koelschlaeger/T-TWR_Keypad/symbols/PTS526_SK15_SMTR2_LFS.stp

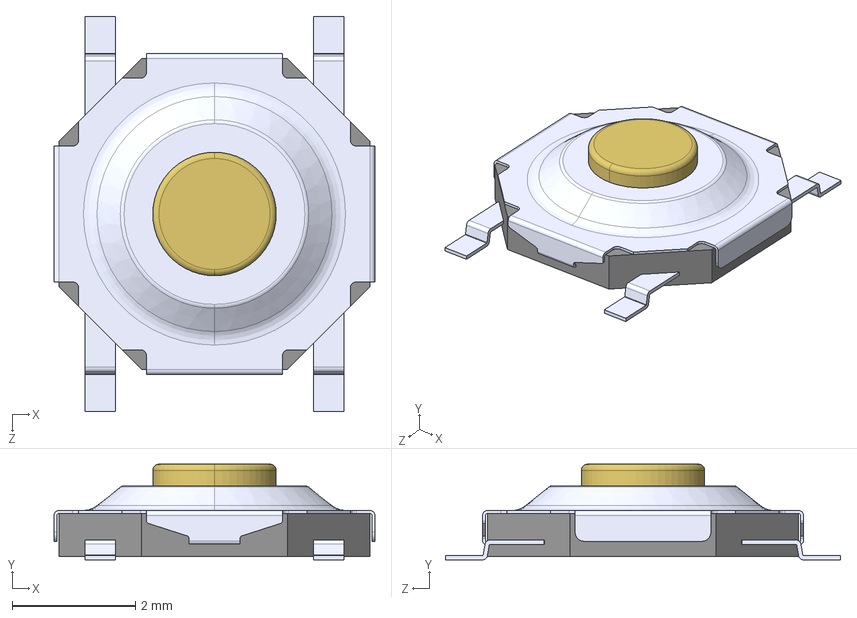
[picture p1: CAD file, 2024-03-25]
symbols/PTS526_SK15_SMTR2_LFS.stp
5.20 x 1.55 x 6.40 mm
