koelschlaeger/T-TWR_Keypad/symbols/RGT0016B.stp

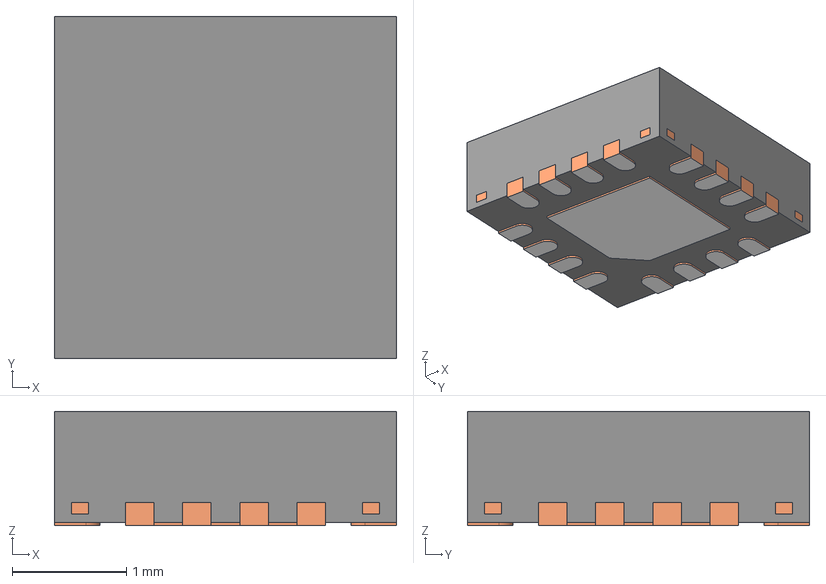
[picture p2: CAD file, 2024-03-25]
symbols/RGT0016B.stp
3.00 x 3.00 x 1.00 mm
BODY-QFN
FRAME-RGT0016B
PIN1-ID
