koelschlaeger/T-TWR_Keypad/symbols/SOT162-1_NXP.step

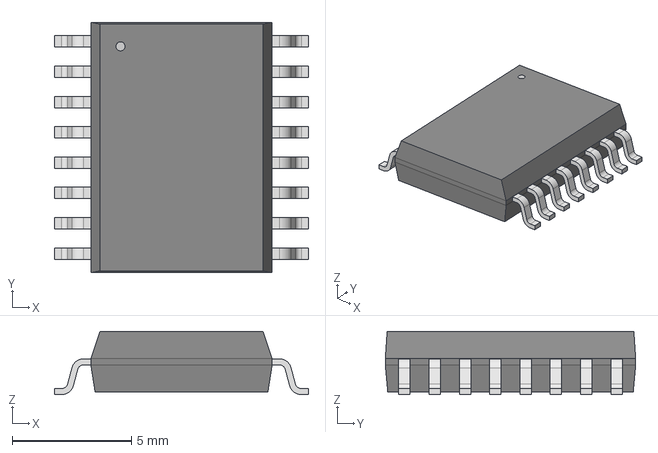
[picture p3: CAD file, 2024-03-25]
symbols/SOT162-1_NXP.step
10.6 x 10.5 x 2.64 mm
