koelschlaeger/T-TWR_Keypad/TTWR Keypad.kicad_pcb

## KiCad design TTWR Keypad.kicad_pcb (2024-04-13)

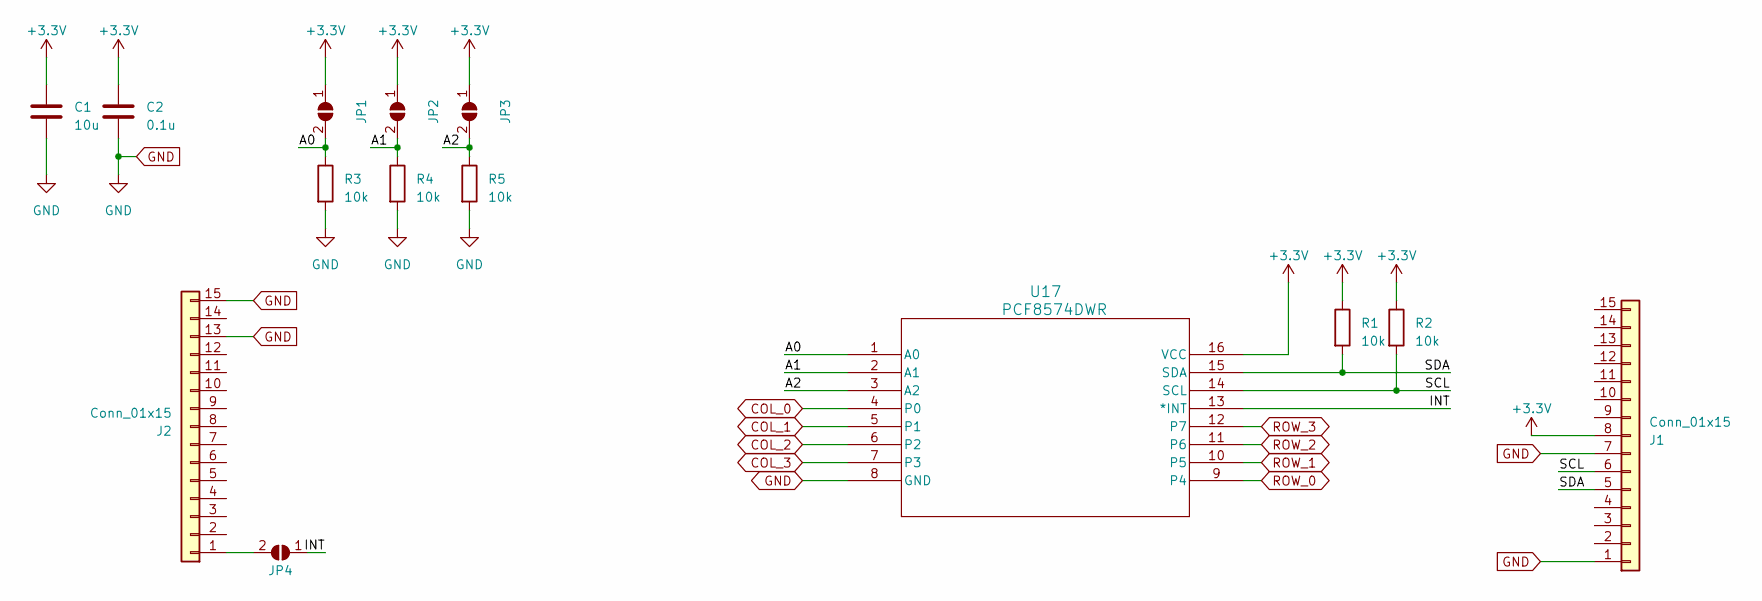
[picture p4: schematic IO Expander.kicad_sch]

Parts:
C1: 10u; C_0603_1608Metric_Pad1.08x0.95mm_HandSolder
C2: 0.1u; C_0603_1608Metric_Pad1.08x0.95mm_HandSolder
J1, J2: Conn_01x15; PinHeader_1x15_P1.00mm_Vertical
JP1, JP2, JP3, JP4: SolderJumper_2_Open; SolderJumper-2_P1.3mm_Open_RoundedPad1.0x1.5mm
R1, R2, R3, R4, R5: 10k; R_0603_1608Metric_Pad0.98x0.95mm_HandSolder
U17: PCF8574DWR; SOT162-1_NXP-M

Connections:
+3.3V: C1.1, C2.1, J1.8, JP1.1 (A), JP2.1 (A), JP3.1 (A), R1.1, R2.1, U17.16 (VCC)
/IO Expander/A0: JP1.2 (B), R3.1, U17.1 (A0)
/IO Expander/A1: JP2.2 (B), R4.1, U17.2 (A1)
/IO Expander/A2: JP3.2 (B), R5.1, U17.3 (A2)
/IO Expander/INT: JP4.1 (A), U17.13 (*INT)
/IO Expander/SCL: J1.6, R2.2, U17.14 (SCL)
/IO Expander/SDA: J1.5, R1.2, U17.15 (SDA)
COL_0: U17.4 (P0); also elsewhere on the board
COL_1: U17.5 (P1); also elsewhere on the board
COL_2: U17.6 (P2); also elsewhere on the board
COL_3: U17.7 (P3); also elsewhere on the board
GND: C1.2, C2.2, J1.1, J1.7, J2.13, J2.15, R3.2, R4.2, R5.2, U17.8 (GND)
unnamed: J2.1, JP4.2 (B)
ROW_0: U17.9 (P4); also elsewhere on the board
ROW_1: U17.10 (P5); also elsewhere on the board
ROW_2: U17.11 (P6); also elsewhere on the board
ROW_3: U17.12 (P7); also elsewhere on the board

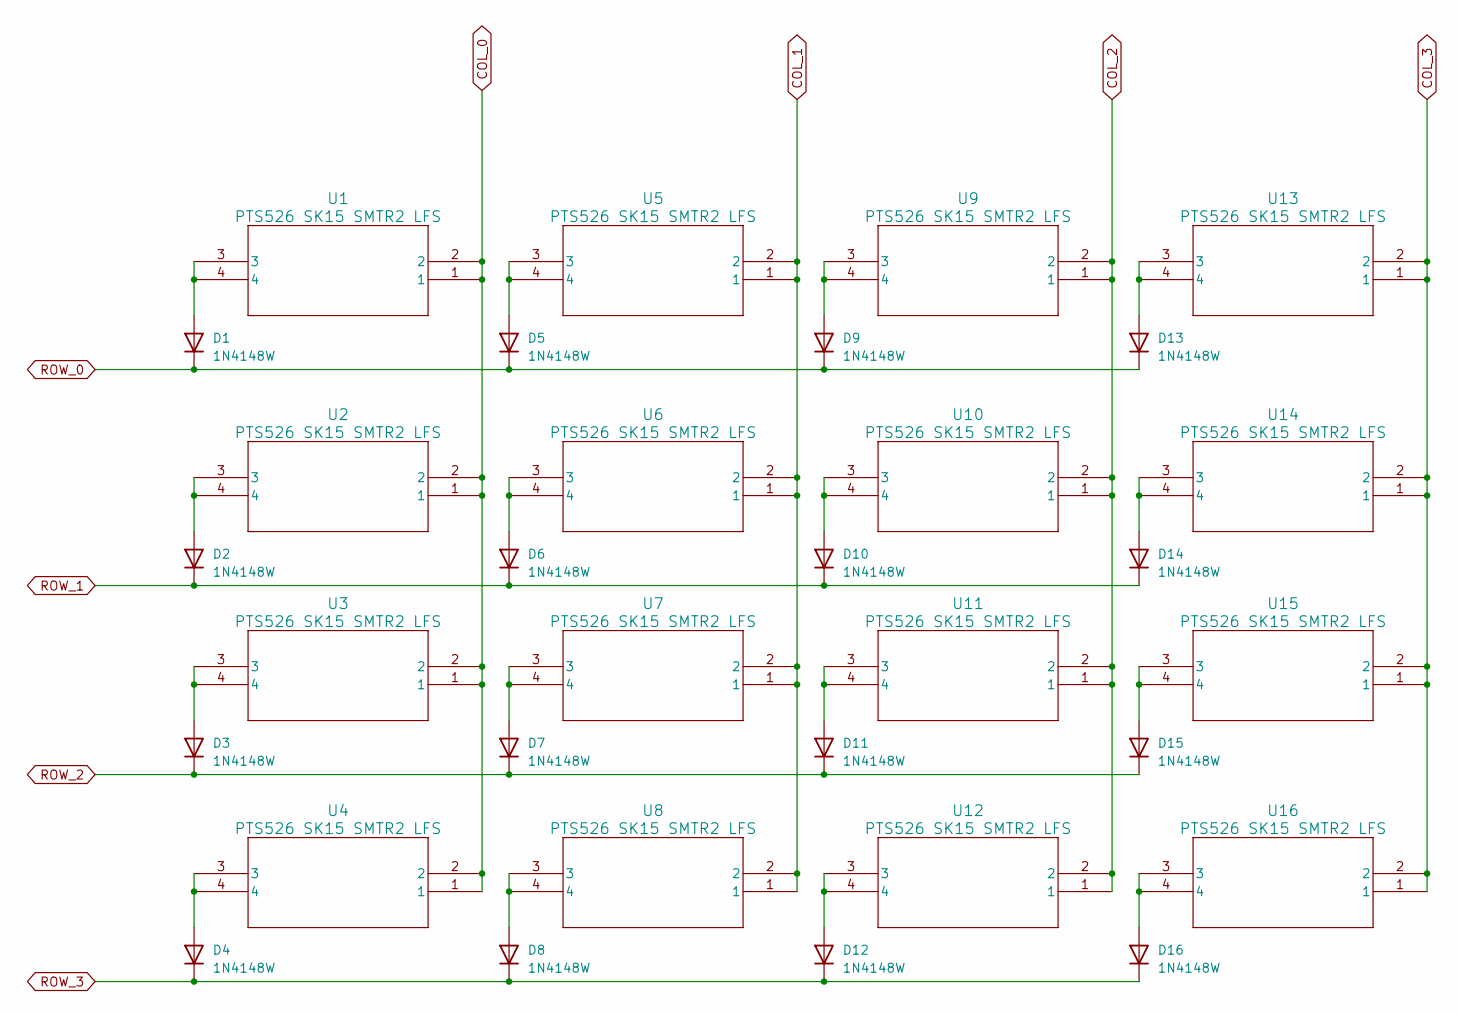
[picture p5: schematic keypad.kicad_sch]

Parts:
D1, D2, D3, D4, D5, D6, D7, D8, D9, D10, D11, D12, D13, D14, D15, D16: 1N4148W; D_SOD-123
U1, U2, U3, U4, U5, U6, U7, U8, U9, U10, U11, U12, U13, U14, U15, U16: PTS526 SK15 SMTR2 LFS; PTS526_SK15_SMTR2_LFS

Connections:
COL_0: U1.1, U1.2, U2.1, U2.2, U3.1, U3.2, U4.1, U4.2; also elsewhere on the board
COL_1: U5.1, U5.2, U6.1, U6.2, U7.1, U7.2, U8.1, U8.2; also elsewhere on the board
COL_2: U9.1, U9.2, U10.1, U10.2, U11.1, U11.2, U12.1, U12.2; also elsewhere on the board
COL_3: U13.1, U13.2, U14.1, U14.2, U15.1, U15.2, U16.1, U16.2; also elsewhere on the board
unnamed: D1.2 (A), U1.3, U1.4
unnamed: D2.2 (A), U2.3, U2.4
unnamed: D3.2 (A), U3.3, U3.4
unnamed: D4.2 (A), U4.3, U4.4
unnamed: D5.2 (A), U5.3, U5.4
unnamed: D6.2 (A), U6.3, U6.4
unnamed: D7.2 (A), U7.3, U7.4
unnamed: D8.2 (A), U8.3, U8.4
unnamed: D9.2 (A), U9.3, U9.4
unnamed: D10.2 (A), U10.3, U10.4
unnamed: D11.2 (A), U11.3, U11.4
unnamed: D12.2 (A), U12.3, U12.4
unnamed: D13.2 (A), U13.3, U13.4
unnamed: D14.2 (A), U14.3, U14.4
unnamed: D15.2 (A), U15.3, U15.4
unnamed: D16.2 (A), U16.3, U16.4
ROW_0: D1.1 (K), D5.1 (K), D9.1 (K), D13.1 (K); also elsewhere on the board
ROW_1: D2.1 (K), D6.1 (K), D10.1 (K), D14.1 (K); also elsewhere on the board
ROW_2: D3.1 (K), D7.1 (K), D11.1 (K), D15.1 (K); also elsewhere on the board
ROW_3: D4.1 (K), D8.1 (K), D12.1 (K), D16.1 (K); also elsewhere on the board

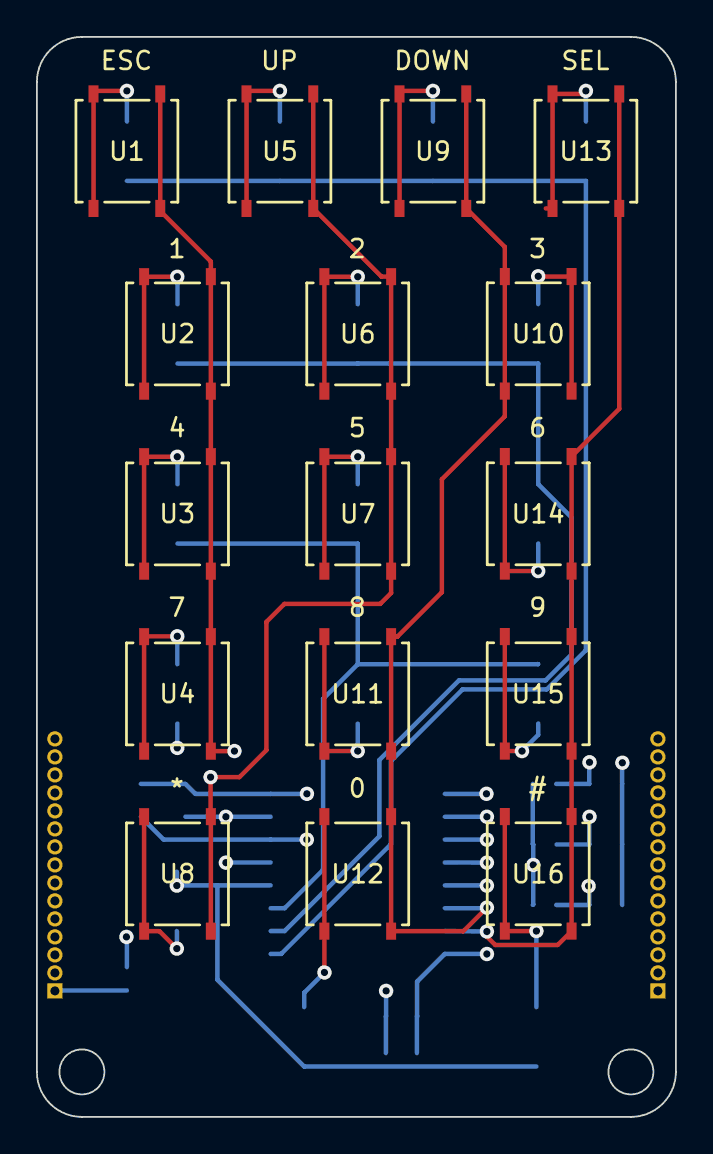
[picture p6: board TTWR Keypad.kicad_pcb from above]

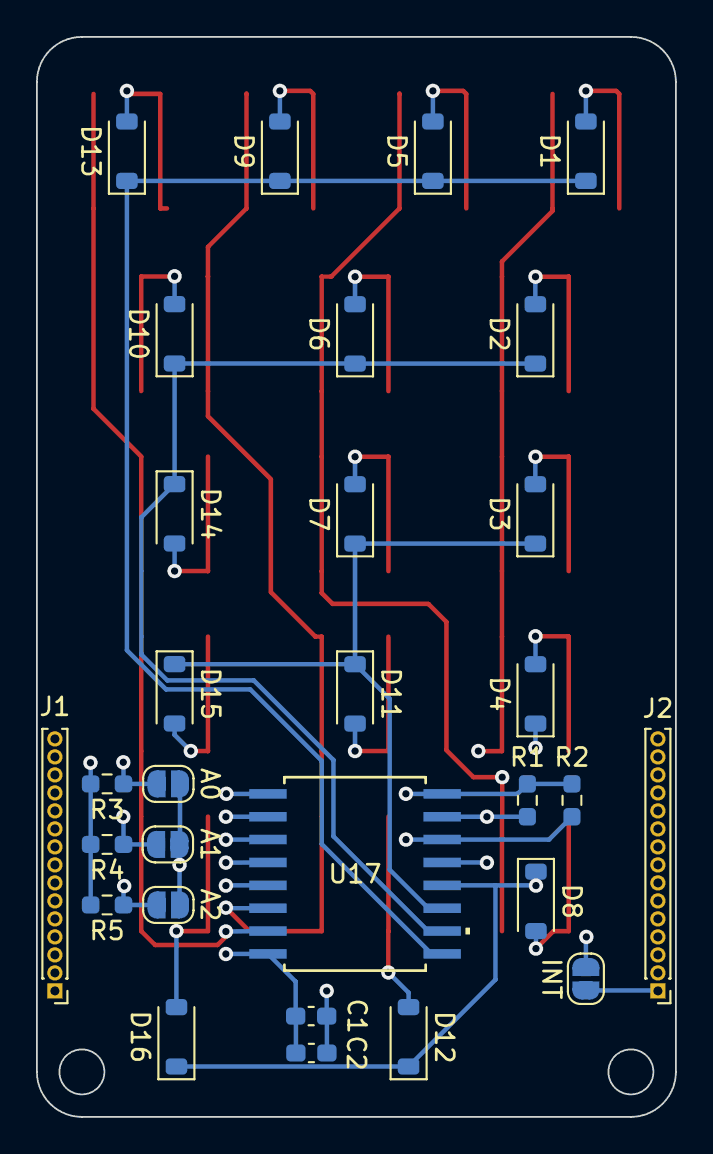
[picture p7: board TTWR Keypad.kicad_pcb from below]

Board: 4 copper layers, 35.5 x 60.0 mm, 46 parts (30 on the bottom side), 33 nets.
