koelschlaeger/T-TWR_Keypad/(commit log)

2024-03-25 Rev 1. New layout on 4 layer board. Changed package/footprint of the IO Expander to SOP-16.
    [IO Expander.kicad_sch, RGT0016B.stp, SOT162-1_NXP.step, TTWR Keypad BoM.csv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]
2024-03-25 Added solid model for switches
    [PTS526_SK15_SMTR2_LFS.stp, TTWR Keypad.kicad_pcb]
2024-03-27 removed zip filter from .gitignore
2024-03-27 Changed footprints of R* and C* to 0603 and made layout adjustments to compensate. Added JLCPCB metafiles for fab and population.
    [BOM-TTWR Keypad.csv, IO Expander.kicad_sch, TTWR Keypad BoM.csv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]
2024-03-29 Added labels for switches. Changed jumper labels to functional labels.
    [BOM-TTWR Keypad.csv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]
2024-04-13 Added ground plane to second inner layer and regenerated gerber files.
    [TTWR Keypad-B_Cu.gbr, TTWR Keypad-B_Mask.gbr, TTWR Keypad-B_Paste.gbr, TTWR Keypad-B_Silkscreen.gbr, TTWR Keypad-CuBottom.gbr, TTWR Keypad-CuIn1.gbr, TTWR Keypad-CuIn2.gbr, TTWR Keypad-CuTop.gbr]
