koelschlaeger/T-TWR_Keypad/(notices)

Notices in the files:
TTWR Keypad.kicad_pcb:
License: CC BY 4.0
